htpse101/acoustic_rangefinder/Schematic/mc_layout03/mc_layout03.kicad_pcb

## KiCad design Schematic/mc_layout03/mc_layout03.kicad_pcb (2018-03-10)

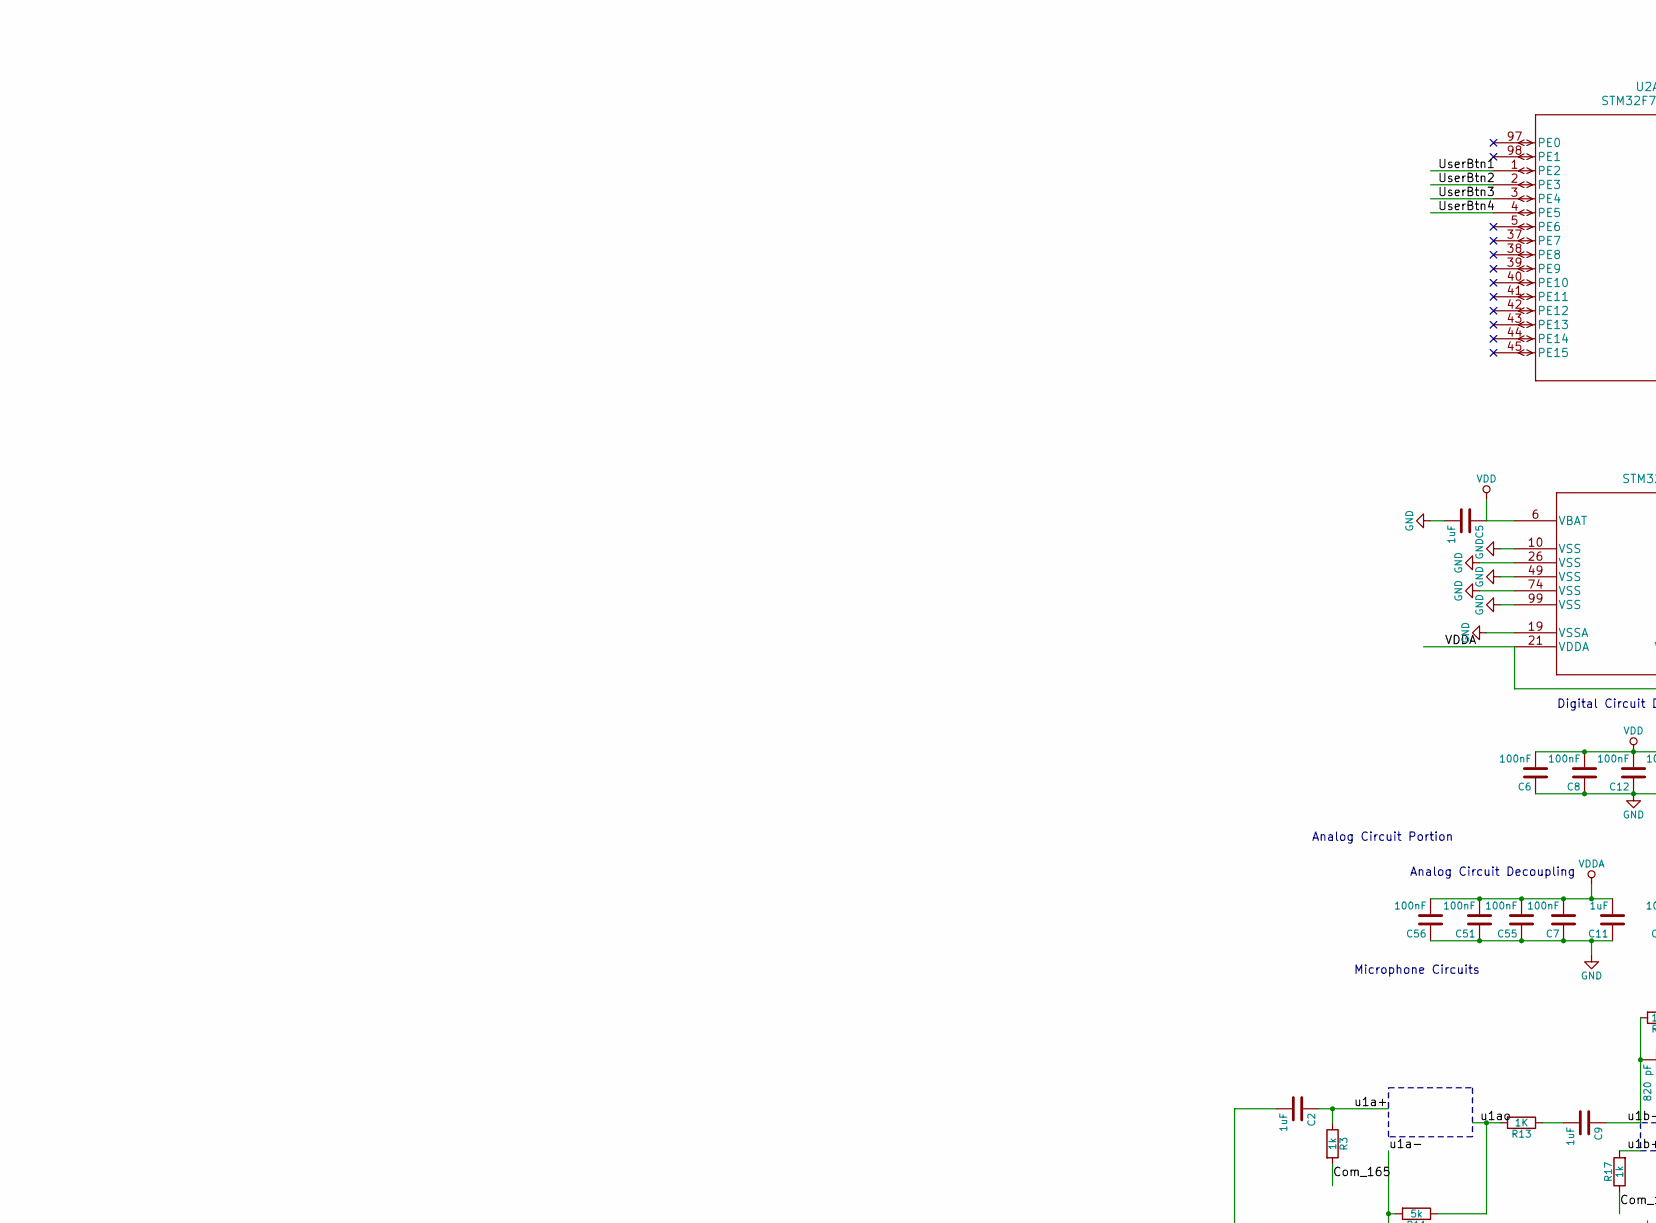
[picture p1: schematic mc_layout03.sch, part in row 1, column 1]

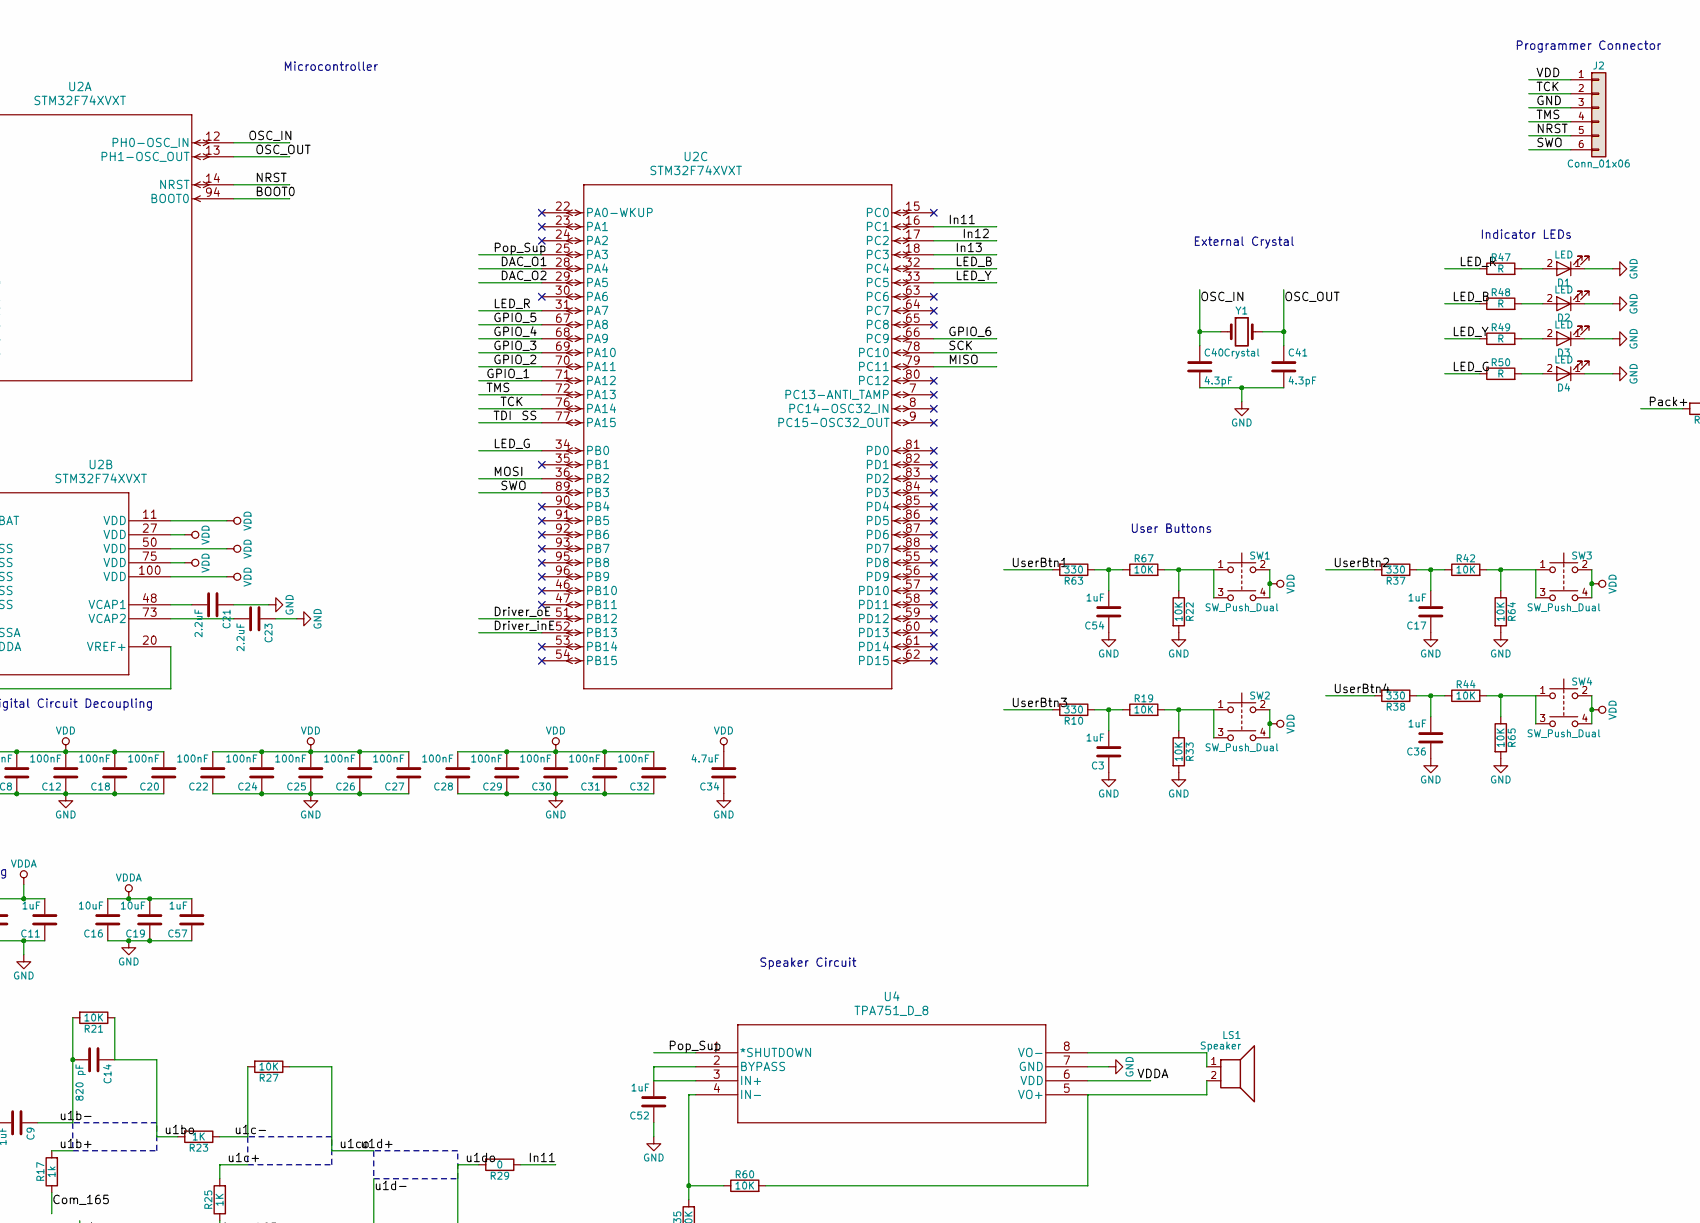
[picture p2: schematic mc_layout03.sch, part in row 1, column 2]

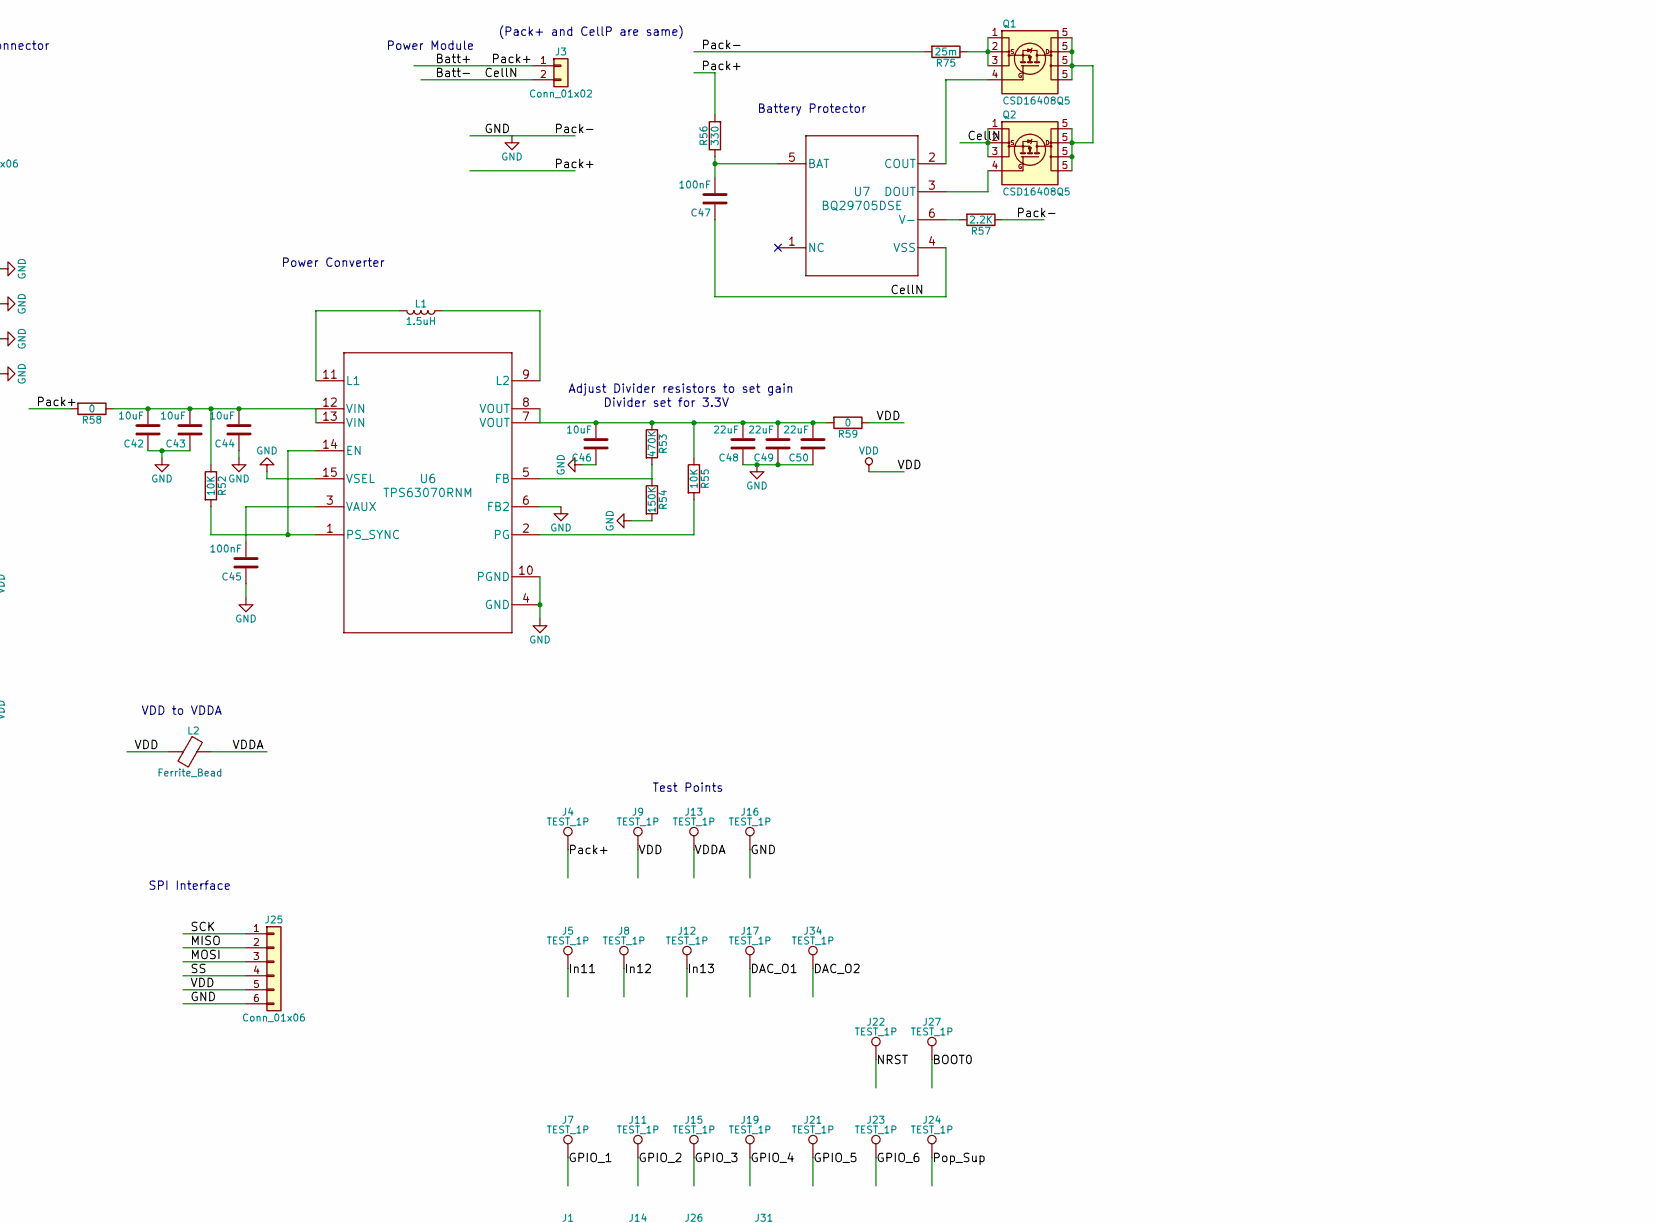
[picture p3: schematic mc_layout03.sch, part in row 1, column 3]

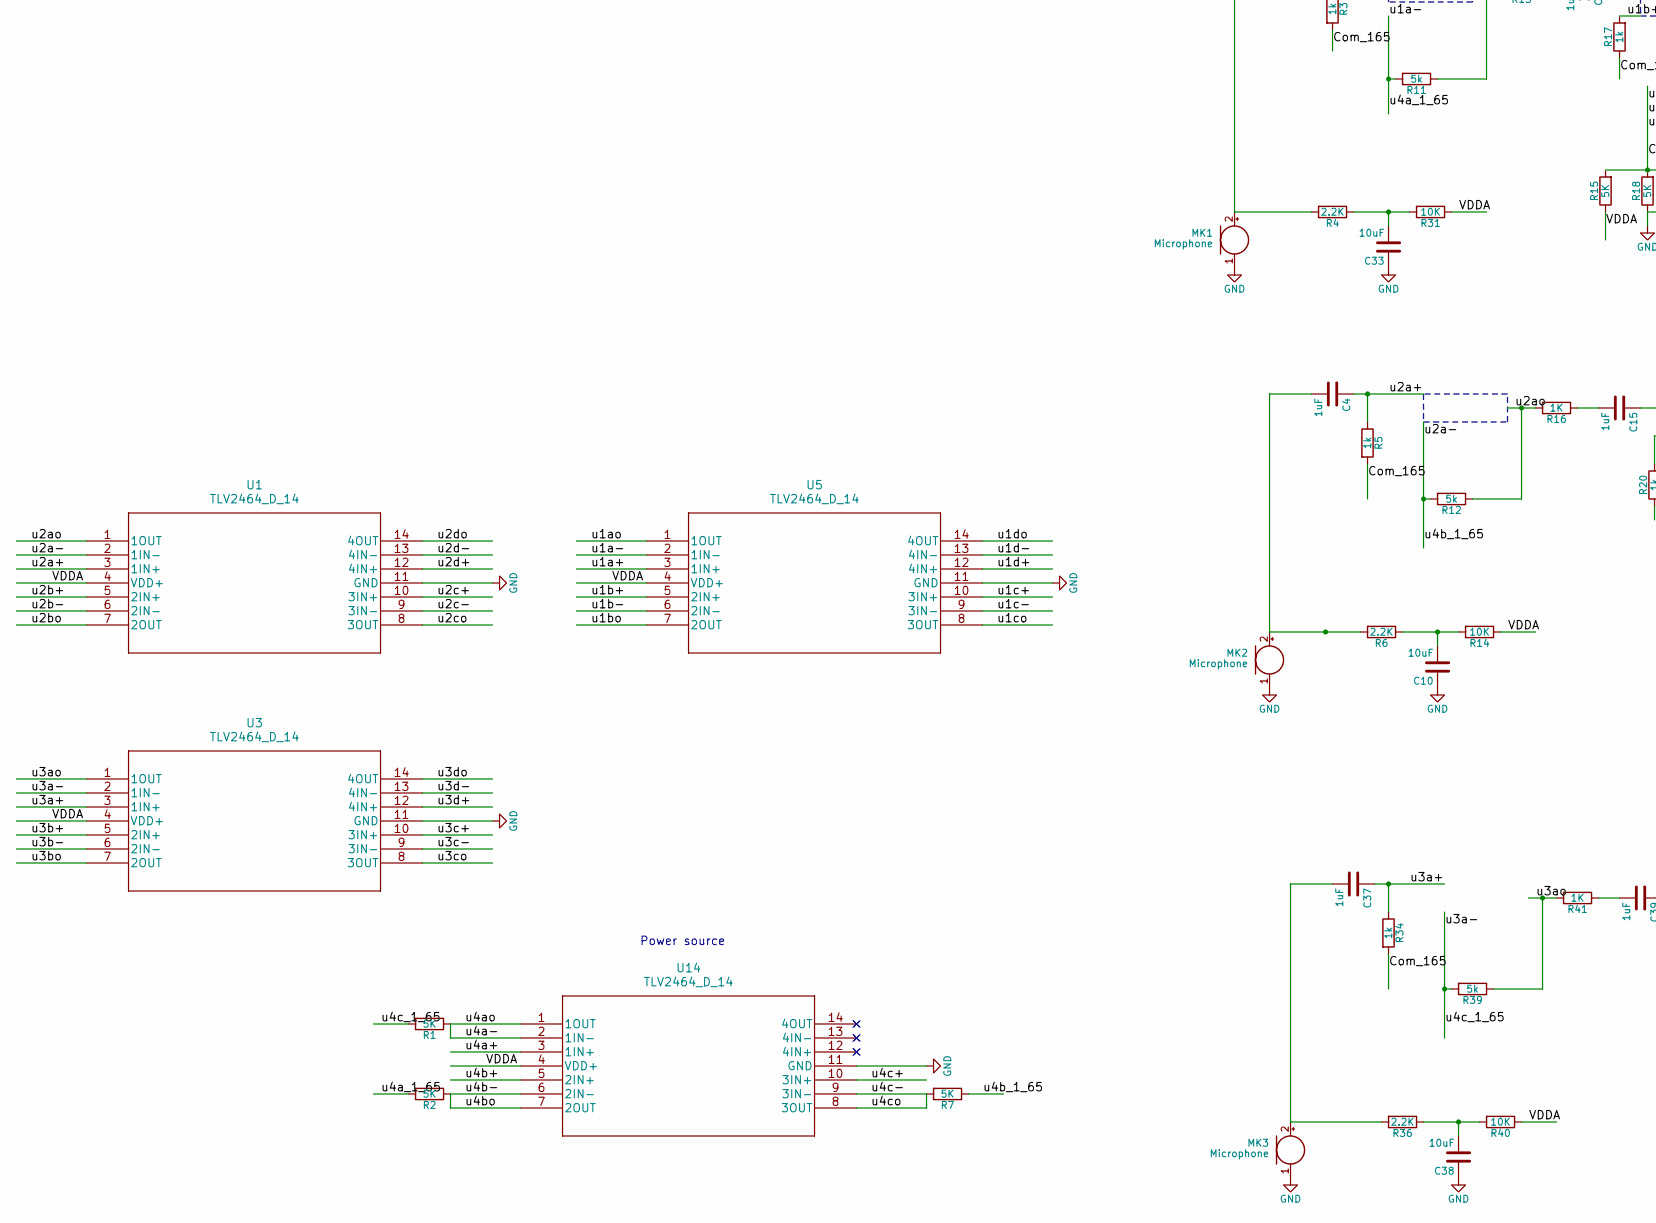
[picture p4: schematic mc_layout03.sch, part in row 2, column 1]

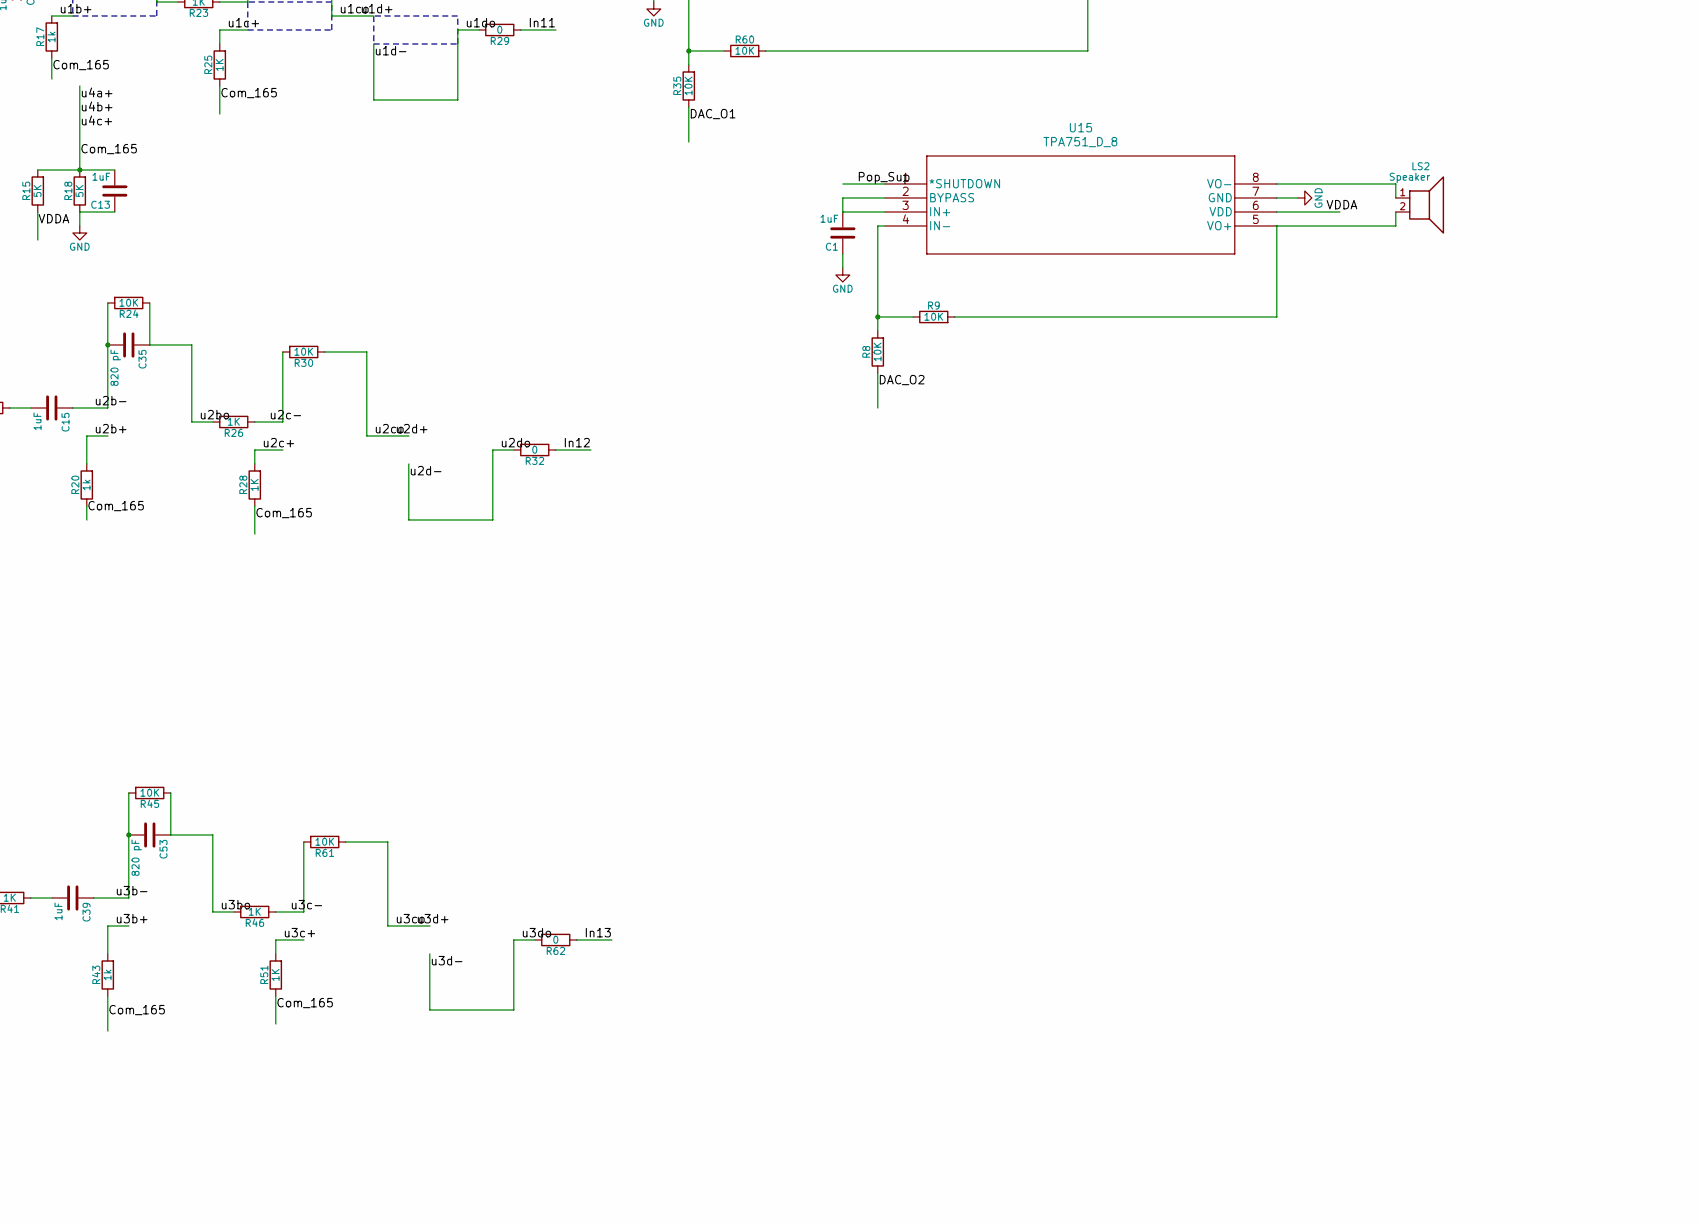
[picture p5: schematic mc_layout03.sch, part in row 2, column 2]

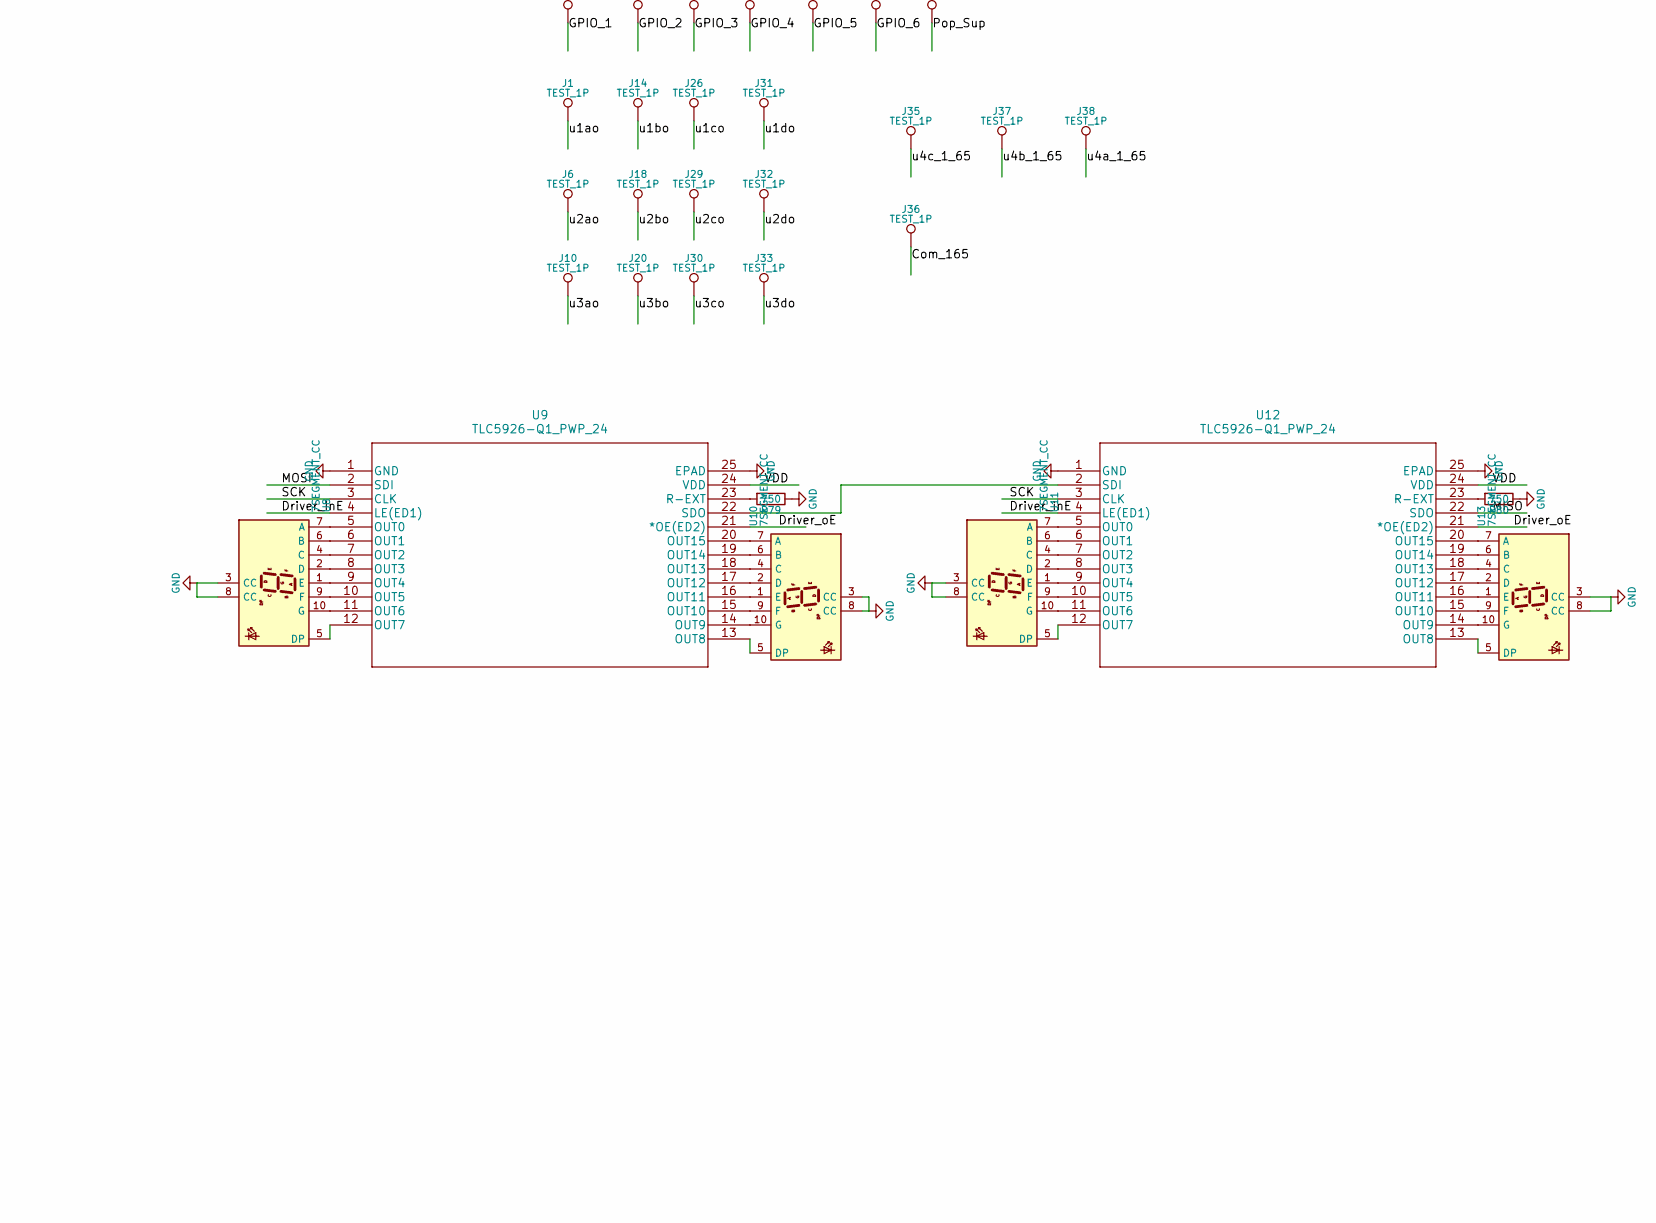
[picture p6: schematic mc_layout03.sch, part in row 2, column 3]

Parts:
C1, C2, C3, C4, C5, C9, C11, C13, C15, C17, C36, C37, C39, C52, C54, C57: 1uF; C_0603
C6, C7, C8, C12, C18, C20, C22, C24, C25, C26, C27, C28, C29, C30, C31, C32, C47, C51, C55, C56: 100nF; C_0603
C10, C16, C19, C33, C38, C44, C46: 10uF; C_0603
C14, C35, C53: 820 pF; C_0603
C21, C23: 2.2uF; C_0603
C34: 4.7uF; C_0603
C40, C41: 4.3pF; C_0603
C42, C43: 10uF; C_0805
C45: 100nF; C_0402
C48, C49, C50: 22uF; C_0805
D1, D2, D3, D4: LED; LED_0603
J1, J4, J5, J6, J8, J9, J10, J12, J13, J14, J16, J17, J18, J20, J22, J24, J26, J27, J29, J30, J31, J32, J33, J34, J35, J36, J37, J38: TEST_1P; TestPt
J2, J25: Conn_01x06; Pin_Header_Straight_1x06_Pitch2.54mm
J3: Conn_01x02; Pin_Header_Straight_1x02_Pitch2.54mm
J7, J11, J15, J19, J21, J23: TEST_1P; LongTestPt
L1: 1.5uH; L_cust01
L2: Ferrite_Bead; L_0603
LS1, LS2: Speaker; Test_Point_2Pads
MK1, MK2, MK3: Microphone; CMC2242PBL
Q1, Q2: CSD16408Q5; CSD16406Q3
R1, R2, R7, R15, R18: 5K; R_0603
R3, R5, R17, R20, R34, R43: 1k; R_0603
R4, R6, R36, R57: 2.2K; R_0603
R8, R9, R14, R19, R21, R22, R24, R27, R30, R31, R33, R35, R40, R42, R44, R45, R52, R55, R60, R61, R64, R65, R67: 10K; R_0603
R10, R37, R38, R56, R63: 330; R_0603
R11, R12, R39: 5k; R_0603
R13, R16, R23, R25, R26, R28, R41, R46, R51: 1K; R_0603
R29, R32, R58, R59, R62: 0; R_0603
R47, R48, R49, R50: R; R_0603
R53: 470K; R_0603
R54: 150K; R_0603
R75: 25m; R_0603
R79, R80: 750; R_0603
SW1, SW2, SW3, SW4: SW_Push_Dual; ADTSM6
U1, U3, U5, U14: TLV2464_D_14
U2: STM32F74XVXT
U4, U15: TPA751_D_8
U6: TPS63070RNM; TPS63070RNMR
U7: BQ29705DSE; BQ29705DSER
U8, U10, U11, U13: 7SEGMENT_CC; INND-SS30
U9, U12: TLC5926-Q1_PWP_24
Y1: Crystal; NX3225GD

Connections:
/BOOT0: J27.1, U2.94 (BOOT0)
/Batt+: J3.1, J4.1, R56.2, R58.2
/Batt-: C47.1, J3.2, Q2.1 (S), Q2.2 (S), Q2.3 (S), U7.4 (VSS)
/Com_165: C13.2, J36.1, R3.2, R5.2, R15.2, R17.1, R18.2, R20.1, R25.1, R28.1, R34.2, R43.1, R51.1, U14.3 (1IN+), U14.5 (2IN+), U14.10 (3IN+)
/DAC_O1: J17.1, R35.1, U2.28 (PA4)
/DAC_O2: J34.1, R8.1, U2.29 (PA5)
/Driver_inE: U2.52 (PB13), U9.4 (LE(ED1)), U12.4 (LE(ED1))
/Driver_oE: U2.51 (PB12), U9.21 (*OE(ED2)), U12.21 (*OE(ED2))
/GPIO_1: J7.1, U2.71 (PA12)
/GPIO_2: J11.1, U2.70 (PA11)
/GPIO_3: J15.1, U2.69 (PA10)
/GPIO_4: J19.1, U2.68 (PA9)
/GPIO_5: J21.1, U2.67 (PA8)
/GPIO_6: J23.1, U2.66 (PC9)
/In11: J5.1, R29.1, U2.16 (PC1)
/In12: J8.1, R32.1, U2.17 (PC2)
/In13: J12.1, R62.1, U2.18 (PC3)
/LED_B: R48.1, U2.32 (PC4)
/LED_G: R50.1, U2.34 (PB0)
/LED_R: R47.1, U2.31 (PA7)
/LED_Y: R49.1, U2.33 (PC5)
/MISO: J25.2, U2.79 (PC11), U12.22 (SDO)
/MOSI: J25.3, U2.36 (PB2), U9.2 (SDI)
/NRST: J2.5, J22.1, U2.14 (NRST)
/OSC_IN: C40.1, U2.12 (PH0-OSC_IN), Y1.1
/OSC_OUT: C41.1, U2.13 (PH1-OSC_OUT), Y1.2
/Pop_Sup: J24.1, U2.25 (PA3), U4.1 (*SHUTDOWN), U15.1 (*SHUTDOWN)
/SCK: J25.1, U2.78 (PC10), U9.3 (CLK), U12.3 (CLK)
/SS: J25.4, U2.77 (PA15); also elsewhere on the board
/SWO: J2.6, U2.89 (PB3)
/TCK: J2.2, U2.76 (PA14)
/TMS: J2.4, U2.72 (PA13)
/UserBtn1: R63.2, U2.1 (PE2)
/UserBtn2: R37.2, U2.2 (PE3)
/UserBtn3: R10.2, U2.3 (PE4)
/UserBtn4: R38.2, U2.4 (PE5)
/u1a+: C2.1, R3.1, U5.3 (1IN+)
/u1a-: J38.1, R2.2, R11.2, U5.2 (1IN-)
/u1ao: J1.1, R11.1, R13.2, U5.1 (1OUT)
/u1b+: R17.2, U5.5 (2IN+)
/u1b-: C9.1, C14.2, R21.2, U5.6 (2IN-)
/u1bo: C14.1, J14.1, R21.1, R23.2, U5.7 (2OUT)
/u1c+: R25.2, U5.10 (3IN+)
/u1c-: R23.1, R27.2, U5.9 (3IN-)
/u1co: J26.1, R27.1, U5.8 (3OUT), U5.12 (4IN+)
/u1d-: J31.1, R29.2, U5.13 (4IN-), U5.14 (4OUT)
/u2a+: C4.1, R5.1, U1.3 (1IN+)
/u2a-: J37.1, R7.1, R12.2, U1.2 (1IN-)
/u2ao: J6.1, R12.1, R16.2, U1.1 (1OUT)
/u2b+: R20.2, U1.5 (2IN+)
/u2b-: C15.1, C35.2, R24.2, U1.6 (2IN-)
/u2bo: C35.1, J18.1, R24.1, R26.2, U1.7 (2OUT)
/u2c+: R28.2, U1.10 (3IN+)
/u2c-: R26.1, R30.2, U1.9 (3IN-)
/u2co: J29.1, R30.1, U1.8 (3OUT), U1.12 (4IN+)
/u2d-: J32.1, R32.2, U1.13 (4IN-), U1.14 (4OUT)
/u3a+: C37.1, R34.1, U3.3 (1IN+)
/u3a-: J35.1, R1.2, R39.2, U3.2 (1IN-)
/u3ao: J10.1, R39.1, R41.2, U3.1 (1OUT)
/u3b+: R43.2, U3.5 (2IN+)
/u3b-: C39.1, C53.2, R45.2, U3.6 (2IN-)
/u3bo: C53.1, J20.1, R45.1, R46.2, U3.7 (2OUT)
/u3c+: R51.2, U3.10 (3IN+)
/u3c-: R46.1, R61.2, U3.9 (3IN-)
/u3co: J30.1, R61.1, U3.8 (3OUT), U3.12 (4IN+)
/u3d-: J33.1, R62.2, U3.13 (4IN-), U3.14 (4OUT)
/u4a-: R1.1, U14.1 (1OUT), U14.2 (1IN-)
/u4b-: R2.1, U14.6 (2IN-), U14.7 (2OUT)
/u4c-: R7.2, U14.8 (3OUT), U14.9 (3IN-)
GND: C1.1, C3.1, C5.2, C6.1, C7.1, C8.1, C10.1, C11.1, C12.1, C13.1, C16.1, C17.1, C18.1, C19.1, C20.1, C21.1, C22.1, C23.1, C24.1, C25.1, C26.1, C27.1, C28.1, C29.1, C30.1, C31.1, C32.1, C33.1, C34.1, C36.1, C38.1, C40.2, C41.2, C42.1, C43.1, C44.1, C45.1, C46.1, C48.1, C49.1, C50.1, C51.1, C52.1, C54.1, C55.1, C56.1, C57.1, D1.1 (K), D2.1 (K), D3.1 (K), D4.1 (K), J2.3, J16.1, J25.6, MK1.1 (-), MK2.1 (-), MK3.1 (-), R18.1, R22.2, R33.2, R54.2, R57.1, R64.2, R65.2, R75.2, R79.1, R80.1, U1.11 (GND), U2.10 (VSS), U2.19 (VSSA), U2.26 (VSS), U2.49 (VSS), U2.74 (VSS), U2.99 (VSS), U3.11 (GND), U4.7 (GND), U5.11 (GND), U6.4 (GND), U6.6 (FB2), U6.10 (PGND), U6.15 (VSEL), U8.3 (CC), U8.8 (CC), U9.1 (GND), U9.25 (EPAD), U10.3 (CC), U10.8 (CC), U11.3 (CC), U11.8 (CC), U12.1 (GND), U12.25 (EPAD), U13.3 (CC), U13.8 (CC), U14.11 (GND), U15.7 (GND)
unnamed: C1.2, U15.2 (BYPASS), U15.3 (IN+)
unnamed: C2.2, MK1.2 (+), R4.2
unnamed: C3.2, R10.1, R19.1
unnamed: C4.2, MK2.2 (+), R6.2
unnamed: C9.2, R13.1
unnamed: C10.2, R6.1, R14.2
unnamed: C15.2, R16.1
unnamed: C17.2, R37.1, R42.1
unnamed: C21.2, U2.48 (VCAP1)
unnamed: C23.2, U2.73 (VCAP2)
unnamed: C33.2, R4.1, R31.2
unnamed: C36.2, R38.1, R44.1
unnamed: C37.2, MK3.2 (+), R36.2
unnamed: C38.2, R36.1, R40.2
unnamed: C39.2, R41.1
unnamed: C42.2, C43.2, C44.2, R52.1, R58.1, U6.12 (VIN), U6.13 (VIN)
unnamed: C45.2, U6.3 (VAUX)
unnamed: C46.2, C48.2, C49.2, C50.2, R53.1, R55.1, R59.2, U6.7 (VOUT), U6.8 (VOUT)
unnamed: C47.2, R56.1, U7.5 (BAT)
unnamed: C52.2, U4.2 (BYPASS), U4.3 (IN+)
unnamed: C54.2, R63.1, R67.1
unnamed: D1.2 (A), R47.2
unnamed: D2.2 (A), R48.2
unnamed: D3.2 (A), R49.2
unnamed: D4.2 (A), R50.2
unnamed: L1.1, U6.9 (L2)
unnamed: L1.2, U6.11 (L1)
unnamed: LS1.1, U4.8 (VO-)
unnamed: LS1.2, R60.2, U4.5 (VO+)
unnamed: LS2.1, U15.8 (VO-)
unnamed: LS2.2, R9.2, U15.5 (VO+)
unnamed: Q1.1 (S), Q1.2 (S), Q1.3 (S), R75.1
unnamed: Q1.4 (G), U7.2 (COUT)
unnamed: Q1.5 (D), Q2.5 (D)
unnamed: Q2.4 (G), U7.3 (DOUT)
unnamed: R8.2, R9.1, U15.4 (IN-)
unnamed: R19.2, R33.1, SW2.1, SW2.3
unnamed: R22.1, R67.2, SW1.1, SW1.3
unnamed: R35.2, R60.1, U4.4 (IN-)
unnamed: R42.2, R64.1, SW3.1, SW3.3
unnamed: R44.2, R65.1, SW4.1, SW4.3
unnamed: R52.2, U6.1 (PS_SYNC), U6.14 (EN)
unnamed: R53.2, R54.1, U6.5 (FB)
unnamed: R55.2, U6.2 (PG)
unnamed: R57.2, U7.6 (V-)
unnamed: R79.2, U9.23 (R-EXT)
unnamed: R80.2, U12.23 (R-EXT)
unnamed: U8.1 (E), U9.9 (OUT4)
unnamed: U8.2 (D), U9.8 (OUT3)
unnamed: U8.4 (C), U9.7 (OUT2)
unnamed: U8.5 (DP), U9.12 (OUT7)
unnamed: U8.6 (B), U9.6 (OUT1)
unnamed: U8.7 (A), U9.5 (OUT0)
unnamed: U8.9 (F), U9.10 (OUT5)
unnamed: U8.10 (G), U9.11 (OUT6)
unnamed: U9.16 (OUT11), U10.1 (E)
unnamed: U9.17 (OUT12), U10.2 (D)
unnamed: U9.18 (OUT13), U10.4 (C)
unnamed: U9.13 (OUT8), U10.5 (DP)
unnamed: U9.19 (OUT14), U10.6 (B)
unnamed: U9.20 (OUT15), U10.7 (A)
unnamed: U9.15 (OUT10), U10.9 (F)
unnamed: U9.14 (OUT9), U10.10 (G)
unnamed: U11.1 (E), U12.9 (OUT4)
unnamed: U11.2 (D), U12.8 (OUT3)
unnamed: U11.4 (C), U12.7 (OUT2)
unnamed: U11.5 (DP), U12.12 (OUT7)
unnamed: U11.6 (B), U12.6 (OUT1)
unnamed: U11.7 (A), U12.5 (OUT0)
unnamed: U11.9 (F), U12.10 (OUT5)
unnamed: U11.10 (G), U12.11 (OUT6)
unnamed: U9.22 (SDO), U12.2 (SDI)
unnamed: U12.13 (OUT8), U13.5 (DP)
unnamed: U12.14 (OUT9), U13.10 (G)
unnamed: U12.15 (OUT10), U13.9 (F)
unnamed: U12.16 (OUT11), U13.1 (E)
unnamed: U12.17 (OUT12), U13.2 (D)
unnamed: U12.18 (OUT13), U13.4 (C)
unnamed: U12.19 (OUT14), U13.6 (B)
unnamed: U12.20 (OUT15), U13.7 (A)
VDD: C5.1, C6.2, C8.2, C12.2, C18.2, C20.2, C22.2, C24.2, C25.2, C26.2, C27.2, C28.2, C29.2, C30.2, C31.2, C32.2, C34.2, J2.1, J9.1, J25.5, L2.2, R59.1, SW1.2, SW1.4, SW2.2, SW2.4, SW3.2, SW3.4, SW4.2, SW4.4, U2.6 (VBAT), U2.11 (VDD), U2.27 (VDD), U2.50 (VDD), U2.75 (VDD), U2.100 (VDD), U9.24 (VDD), U12.24 (VDD)
VDDA: C7.2, C11.2, C16.2, C19.2, C51.2, C55.2, C56.2, C57.2, J13.1, L2.1, R14.1, R15.1, R31.1, R40.1, U1.4 (VDD+), U2.20 (VREF+), U2.21 (VDDA), U3.4 (VDD+), U4.6 (VDD), U5.4 (VDD+), U14.4 (VDD+), U15.6 (VDD)

Notes on the sheet:
Microcontroller
Microphone Circuits
Speaker Circuit
Programmer Connector
Power Module
External Crystal
Indicator LEDs
Battery Protector
Power Converter
Adjust Divider resistors to set gain
Divider set for 3.3V
(Pack+ and CellP are same)
Analog Circuit Portion
Digital Circuit Decoupling
Analog Circuit Decoupling
Test Points
User Buttons
VDD to VDDA
SPI Interface
Power source

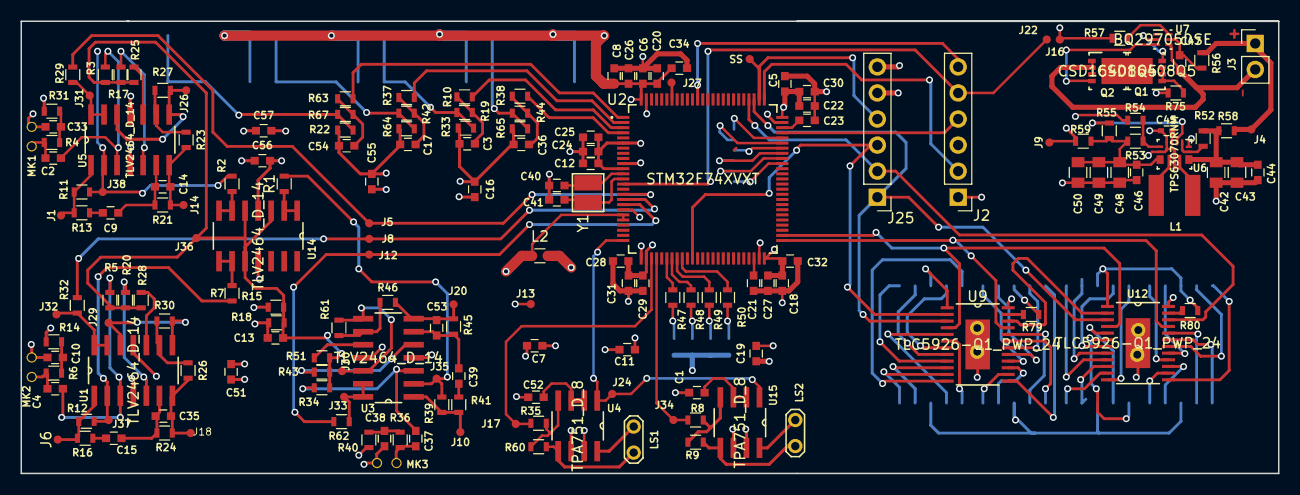
[picture p7: board mc_layout03.kicad_pcb from above]

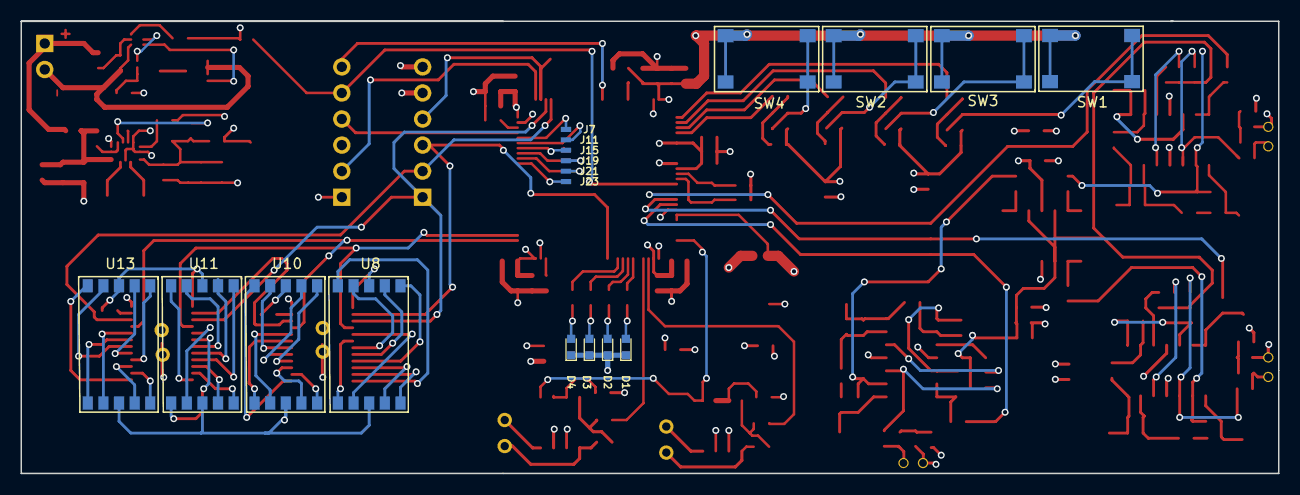
[picture p8: board mc_layout03.kicad_pcb from below]

Board: 4 copper layers, 122.6 x 44.1 mm, 197 parts (18 on the bottom side), 152 nets.

Other parts of the board:
SS: TEST_1P; TestPt

Their connections:
/SS: SS.1; also elsewhere on the board
