htpse101/acoustic_rangefinder/(commit log)

2018-02-19 #2 This is the reverted version. Before it was committed, it was verified that it successfully made a distance measurement by accessing both the ADC and DAC. This code is not in a broken state. It co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
    [main.c]
2018-03-10 Issue #3 These files are the schematic.
    [mc_layout03.kicad_pcb, mc_layout03.sch, mc_layout03_05.kicad_pcb, mc_layout03_06.kicad_pcb, mc_layout03_07.kicad_pcb, v10.kicad_pcb, v11.kicad_pcb, v7.kicad_pcb]
2018-03-10 Issue #1 Updated the Calculations.xlsx file. It now has details about the schematic layout and some of the registers for troubleshooting the DMA and ADC issues.
2018-03-13 Issue #1 This code has updates to allow more functionality with sampling off several pins sequentially.
    [main.c]
2018-03-13 Issue #1 Updated the project files to make them much cleaner. The DAC does not currently run properly. The timers are also off and need to be re-scaled.
    [main.c]
