htpse101/acoustic_rangefinder/(notices)

Notices in the files:
tim-all-02/src/main.c:
(C) COPYRIGHT STMicroelectronics *****END OF FILE
parts and their libraries:
Copyright 2016 Accelerated Designs. All rights reserved.
